ManuelRs1701/ROBOTICA/README.md

# ROBOTICA
Proyecto Final de Robotica
Robot antropomorfico de 4 grados de libertad
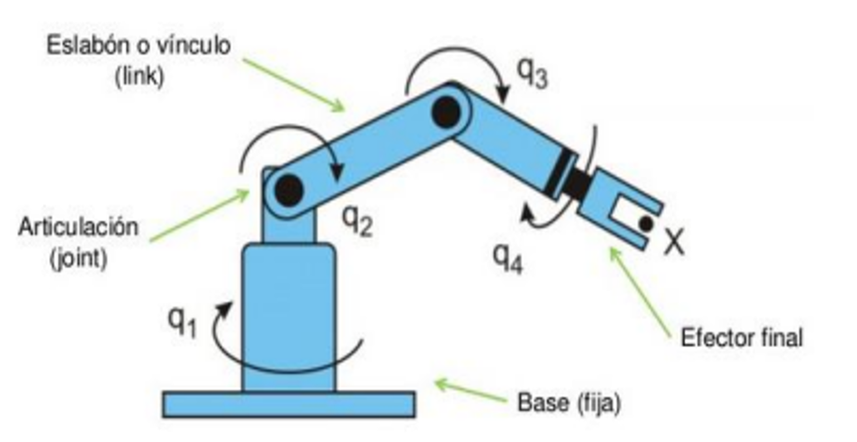
[picture p1: myt2022-040-fig1.png]
Mi imagen
