ManuelRs1701/ROBOTICA/PAPER FINAL ROBOT ANTROPOMORFICO.pdf

# Robot Antropomorfico de 4 Grados de Libertad

Emanuel Roman S ´ anchez ´
Universidad Catolica Boliviana ”San Pablo” ´ Estudiante - Ingeniería Mecatronica ´ emanuel.roman@ucb.edu.bo

Msc. Jose Jes ´ us Cabrera Pantoja ´
Universidad Catolica Boliviana ”San Pablo” ´ Docente - Ingeniería Mecatronica ´ jcabrera@ucb.edu.bo

Abstract—El presente documento detalla el desarrollo de un robot antropomorfico de cuatro grados de libertad, incluyendo ´
los calculos necesarios para su dise ´ | no, as ˜ | í como el analisis ´
de su cinematica directa e inversa. Adem ´ | as, se describen las ´
pruebas realizadas tanto en simulacion como en escenarios reales, ´ destacando los resultados obtenidos en cada etapa.
Index Terms—robot antropomorfico, grados de libertad, inge- ´
niería mecatronica, dise ´ | no, control ˜
I. INTRODUCCION´
La robotica es una disciplina que integra diversas ´ | areas de la ´
ingeniería, la informatica y las ciencias aplicadas, enfoc ´ | andose ´
en el diseno, construcci ˜ | on y operaci ´ | on de robots para realizar ´
tareas específicas de manera autonoma o semiaut ´ | onoma [1]. ´
Su importancia en el mundo actual radica en su capacidad para automatizar procesos, mejorar la eficiencia y precision´ en diversas industrias, y ofrecer soluciones innovadoras a problemas complejos [2].
Dentro de la robotica, los robots antropom ´ | orficos, tambi ´ | en´
conocidos como robots humanoides, son aquellos que emulan la forma y, en cierta medida, el comportamiento humano. Estos robots estan dise ´ nados para interactuar en entornos concebidos ˜ para personas, facilitando tareas que requieren adaptabilidad
y versatilidad [3]. Ademas, su aplicaci ´ | on en campos como ´
la medicina, la educacion y el entretenimiento ha aumentado ´
significativamente en los ultimos a ´ | nos [8]. ˜
Un concepto fundamental en el diseno y an ˜ | alisis de robots es ´
el de los grados de libertad (GDL), que representan el numero ´ de movimientos independientes que un robot puede realizar. En el caso de los robots antropomorficos, generalmente poseen ´ entre cinco y seis grados de libertad, permitiendo una amplia gama de movimientos y una mayor flexibilidad para ejecutar tareas complejas [4]. Esto los hace ideales para aplicaciones que requieren interacciones precisas y detalladas [6].
La | relevancia | de | estudiar | y | desarrollar | robots
antropomorficos radica en su potencial para revolucionar ´
diversas areas de la sociedad. Por ejemplo, en el ´ | ambito ´
industrial, estos robots pueden automatizar procesos que anteriormente dependían de habilidades humanas, mejorando la productividad y reduciendo los costos [7]. En la medicina,
los robots antropomorficos est ´ | an siendo utilizados para ´
realizar cirugías complejas con una precision inigualable, ´ mejorando los resultados clínicos y minimizando los riesgos [8].
Ademas, los avances en la rob ´ | otica permiten desarrollar ´
modelos cada vez mas avanzados que incorporan sensores, ac- ´ tuadores y algoritmos de control mas eficientes. Estos avances ´ han impulsado el uso de robots antropomorficos no solo en ´ entornos laborales, sino tambien en el hogar, donde pueden ´ asistir en tareas domesticas o incluso en el cuidado de personas ´ [3]. Por lo tanto, el estudio de estos sistemas roboticos no solo ´
contribuye al progreso tecnologico, sino que tambi ´ | en tiene un ´
impacto directo en la calidad de vida de las personas.
El proposito de este proyecto es dise ´ | nar y construir un brazo ˜
robotico funcional con cuatro grados de libertad, integrando ´ los conocimientos adquiridos durante el curso. Utilizando Python, MATLAB y Arduino IDE, se implementa un sistema
que proporciona retroalimentacion precisa sobre la posici ´ | on´
del efector final, lo cual facilita el aprendizaje y la aplicacion´
practica de los conceptos de cinem ´ | atica directa e inversa. ´

II. FUNDAMENTO TEORICO ´

A. Definicion de Grados de Libertad ´

Los grados de libertad (GDL) son una medida fundamental
en la robotica que define el n ´ | umero de movimientos indepen- ´
dientes que un sistema puede realizar [9]. En el contexto de un robot de cuatro grados de libertad, estos representan las articulaciones o ejes sobre los cuales el robot puede girar o desplazarse. Comprender los GDL es esencial para el diseno y ˜ analisis de robots, ya que permite determinar las capacidades ´ del sistema y las limitaciones en sus movimientos.


Fig. 1. Diagrama conceptual de los grados de libertad en un brazo robotico. ´

Este diagrama conceptual ilustra los grados de libertad (GDL) en un brazo robotico t ´ ípico. En la figura se muestran las articulaciones (joints) y los eslabones o vínculos (links) que componen la estructura del robot, destacando como cada ´ articulacion permite un movimiento independiente. Los grados ´ de libertad estan representados por las variables q1, q2, q3, ´ q4, que corresponden a las rotaciones o desplazamientos que el robot puede realizar en sus diferentes ejes. Ademas, se ´ identifica el efector final, que es el punto en el extremo del brazo encargado de realizar tareas específicas, y la base fija, que proporciona estabilidad al sistema. Este esquema es esencial para comprender como los movimientos de cada ´ articulacion se combinan para posicionar el efector final en el ´ espacio tridimensional.

B. Cinematica Directa ´
La cinematica es una rama de la rob ´ | otica que estudia ´
el movimiento de los sistemas mecanicos sin considerar las ´ fuerzas que los generan [10]. La cinematica directa se centra ´
en calcular la posicion y orientaci ´ | on del efector final a partir de ´
los valores conocidos de las articulaciones. Estas tecnicas son ´ fundamentales para el control y programacion de robots, ya ´ que permiten planificar trayectorias y movimientos precisos.
El calculo de la cinem ´ | atica directa se lleva a cabo utilizando ´
matrices de transformacion homog ´ | enea, las cuales combinan ´
tanto las rotaciones como los desplazamientos generados por las articulaciones del robot. En general, la transformacion´
homogenea para una articulaci ´ | on´ q se representa mediante la
matriz T, que esta compuesta por una matriz de rotaci ´ | on´ C y
un vector de desplazamiento r:

T =

Ci | r
0 | 1
(1)

donde:
- T: Matriz de transformada homogenea. ´
- Ci
: Matriz de rotacion. ´
- r: Vector de desplazamiento.
Las rotaciones en el espacio tridimensional son un aspecto esencial en la cinematica directa, particularmente cuando el robot ´ opera en un entorno tridimensional. La matriz de rotacion´ C
define como cambia la orientaci ´ | on del efector final respecto ´
al sistema de coordenadas base. Las rotaciones en torno a los ejes x, y y z estan representadas por las siguientes matrices: ´

Cx =

1 | 0 | 0

0 cos(θ) − sin(θ)

0 sin(θ) cos(θ)

(2)

Cy =

cos(θ) | 0 sin(θ)
0 | 1 | 0

− sin(θ) 0 cos(θ)

(3)

Cz =

cos(θ) − sin(θ) 0

sin(θ) | cos(θ) | 0
0 | 0 | 1

(4)

donde:

- Ci
: Matriz de rotacion en torno a un eje espec ´ | ífico.
- θ: Angulo de rotaci ´ | on del motor, expresado en radianes. ´

El desplazamiento de coordenadas se refiere al cambio de origen entre dos sistemas de referencia, generalmente entre la base del robot y el efector final. Cuando se utiliza un sistema de coordenadas (x, y, z) en la base y otro (x

′

, y′

, z′
) en el
efector final, la relacion entre ambos puede representarse me- ´
diante una matriz de transformacion homog ´ | enea que combina ´
rotaciones y traslaciones. El vector de traslacion´ r esta dado ´ por:

r =

x

y

z

(5)

donde:
- r: Representa el vector de traslacion. ´
Para determinar la posicion y orientaci ´ | on del efector final ´
(E) respecto al sistema de referencia inicial (I), se utiliza una secuencia de transformaciones homogeneas. Cada matriz ´ Ti−1,i describe como se transforma el sistema de coordenadas ´
de una articulacion “ ´ | i − 1” al sistema de la articulacion “ ´ | i”,
incorporando tanto rotaciones como desplazamientos. Esto se expresa como:

TI,E = TI,0 ·

Yn

i=1

Ti−1,i · Tn,E | (6)

donde:
- TI,E: Matriz de transformacion del sistema base ( ´ | I) al
efector final (E).
- TI,0: Matriz de transformacion inicial. ´
- Ti−1,i: Matriz de transformacion homog ´ | enea entre las ´
articulaciones i − 1 e i.
- Tn,E: Matriz de transformacion homog ´ | enea desde la ´
ultima articulaci ´ | on hasta el efector final. ´
La ecuacion (6) representa la transformaci ´ | | on completa ´
desde la base del robot hasta el efector final, integrando las rotaciones y traslaciones de todas las articulaciones. Este conjunto de transformaciones permite calcular la posicion y ´
orientacion del efector final seg ´ | un la configuraci ´ | on espec ´ | ífica
de cada articulacion. Al multiplicar todas las matrices en se- ´ cuencia, se obtiene la transformacion acumulada que describe ´ como se posiciona el efector final en el espacio tridimensional. ´
C. Cinematica Inversa ´
La cinematica inversa es un proceso esencial en la rob ´ | | | otica ´
que se utiliza para determinar las configuraciones articulares necesarias para que el efector final alcance una posicion y ´ orientacion deseadas en el espacio [11]. A diferencia de la ´
cinematica directa, que calcula la posici ´ | on del efector final ´
a partir de los valores conocidos de las articulaciones, la cinematica inversa resuelve el problema inverso, lo cual la ´ hace mas compleja debido a la naturaleza no lineal de las ´ ecuaciones involucradas.

Existen varios metodos para resolver la cinem ´ | atica inversa, ´
los cuales incluyen:
- Solucion anal ´ | ítica: Este enfoque consiste en resolver
directamente las ecuaciones algebraicas derivadas de la
transformacion homog ´ | enea. Es ´ | util en robots con config- ´
uraciones simples y simetricas, ya que permite obtener ´ soluciones exactas cuando las ecuaciones son manejables.
- Metodo num ´ | erico ´ | : Se basa en algoritmos iterativos,
como el metodo de Newton-Raphson, para aproximar las ´ soluciones. Este enfoque es ideal para robots con config-
uraciones mas complejas donde las soluciones anal ´ | íticas
no son factibles.
- Optimizacion´ : Utiliza tecnicas de optimizaci ´ | on para min- ´
imizar una funcion de costo que mide la diferencia entre ´
la posicion y orientaci ´ | on deseadas y las alcanzadas por el ´
efector final. Este metodo es com ´ | un en sistemas redun- ´
dantes o cuando existen multiples soluciones posibles. ´
- Aprendizaje basado en datos: En aplicaciones avan-zadas, como la robotica adaptativa, se utilizan redes neu- ´ ronales y otros modelos de aprendizaje para aproximar la solucion a partir de datos previos, lo cual puede ser ´ efectivo en entornos dinamicos. ´
Estos metodos permiten resolver problemas de cinem ´ | atica ´
inversa en una amplia variedad de sistemas roboticos, depen- ´ diendo de la complejidad del robot y de los requisitos de la tarea específica.
D. Servomotores
Los servomotores son actuadores esenciales en robotica, ´
disenados para controlar la posici ˜ | on, velocidad y torque ´
de una manera precisa [12]. A diferencia de los motores convencionales, los servomotores incluyen un sistema de retroalimentacion que permite ajustar continuamente su fun- ´ cionamiento para alcanzar los valores deseados.
1) Funcionamiento de los Servomotores: Un servomotor típico consta de tres componentes principales:
- Motor de corriente continua (DC): Genera el movimiento rotacional.
- Sistema de control: Regula la posicion y velocidad del ´ motor mediante senales de entrada (normalmente PWM). ˜
- Sensor de posicion´ : Mide la posicion angular del eje y ´ proporciona retroalimentacion al sistema de control. ´
El sistema de control compara la senal de referencia ˜
(posicion deseada) con la posici ´ | on actual y ajusta el motor para ´
minimizar el error. Este ciclo de retroalimentacion asegura un ´ control preciso en tiempo real.
2) Aplicaciones en Robotica: ´ En robotica, los servomotores ´ se utilizan comunmente para: ´
- Controlar las articulaciones de brazos roboticos. ´
- Manejar pinzas y herramientas de precision. ´
- Ajustar camaras o sensores para seguimiento din ´ | amico. ´
La capacidad de controlar con precision el movimiento hace ´ que los servomotores sean ideales para tareas que requieren alta repetitividad y exactitud, como en robots industriales y medicos. ´
3) Tipos de Servomotores: Los servomotores se clasifican principalmente en:
- Servomotores de corriente continua (DC): Populares por su simplicidad y rapidez en respuesta.
- Servomotores de corriente alterna (AC): Mas robustos ´ y adecuados para aplicaciones industriales de alta potencia.
- Servomotores digitales: Utilizan microcontroladores para un control mas preciso y personalizable. ´
Cada tipo de servomotor tiene sus ventajas segun la apli- ´
cacion, el rango de potencia y los requisitos de precisi ´ | on. ´
4) Consideraciones de Diseno: ˜ | Al seleccionar servomo-
tores para un proyecto robotico, es fundamental considerar ´ parametros como: ´
- Torque maximo necesario para mover las articulaciones. ´
- Velocidad angular requerida segun la tarea. ´
- Voltaje de operacion y compatibilidad con el sistema. ´
- Rango de movimiento angular y precision. ´
Estos factores aseguran que el sistema robotico funcione de ´ manera eficiente y confiable.

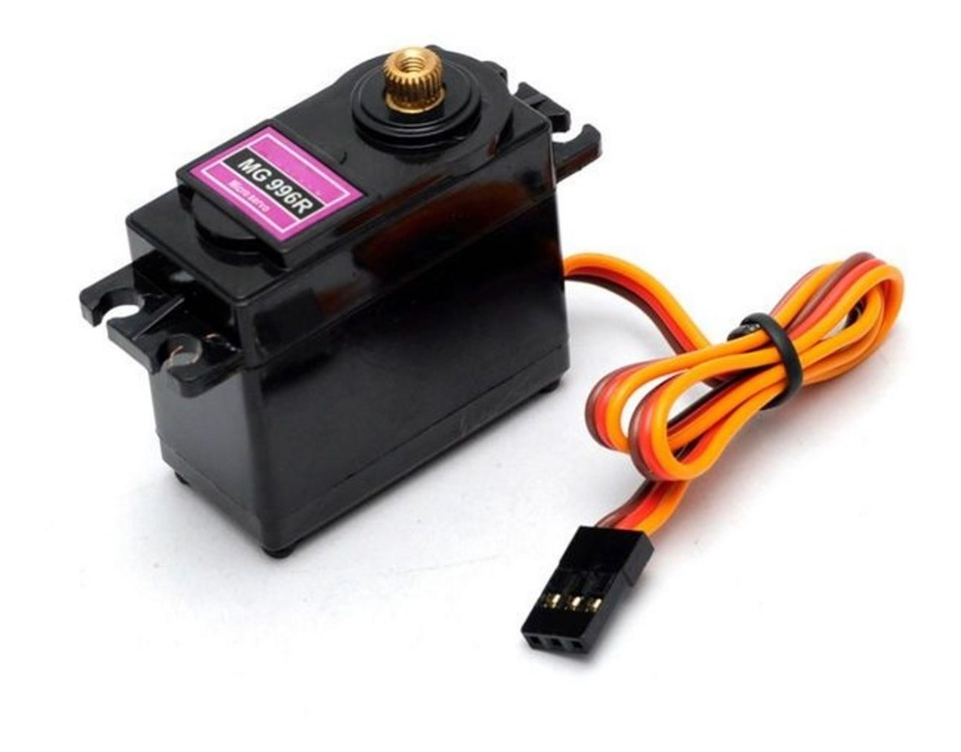
[picture p2: figure]

Fig. 2. Ejemplo de servomotor utilizado en aplicaciones roboticas. ´

E. Controlador PCA9685

El PCA9685 es un controlador de modulacion por ancho ´ de pulso (PWM) altamente eficiente y ampliamente utilizado
en proyectos de robotica y automatizaci ´ | on. Este dispositivo ´
permite controlar hasta 16 canales PWM de forma simultanea, ´ lo que lo hace ideal para manejar multiples servomotores en ´ un sistema robotico [ ´ ?].
1) Características Principales: El PCA9685 se destaca por las siguientes características:
- Control de 16 canales PWM independientes.
- Frecuencia ajustable de hasta 1.6 kHz.
- Comunicacion a trav ´ | es del protocolo I2C. ´
- Alimentacion flexible: puede operar con tensiones de ´ 3.3V o 5V.
- Capacidad para apilar multiples controladores mediante ´ la configuracion de direcciones I2C. ´

2) Funcionamiento: El PCA9685 genera senales PWM ˜ precisas para controlar dispositivos como servomotores y LEDs. Utiliza una comunicacion I2C para recibir comandos ´ desde un microcontrolador (como Arduino o Raspberry Pi), lo que simplifica el cableado y permite una configuracion´
rapida. Los valores de PWM se ajustan a trav ´ | es de registros ´
internos, permitiendo modificar la posicion de servomotores o ´ la intensidad de LEDs.
3) Aplicaciones en Robotica: ´ En proyectos roboticos, el ´ PCA9685 es particularmente util para: ´
- Controlar brazos roboticos con m ´ | ultiples articulaciones. ´
- Coordinar el movimiento de servomotores en robots bípedos o humanoides.
- Regular la intensidad de luces en sistemas de senalizaci ˜ on. ´
Gracias a su capacidad para manejar multiples canales ´
con precision, el PCA9685 es una herramienta vers ´ | atil para ´
sistemas roboticos complejos. ´
4) Ventajas: El PCA9685 ofrece varias ventajas, incluyendo:
- Reduccion del uso de pines de microcontroladores gracias ´ al protocolo I2C.
- Control de multiples dispositivos con un solo m ´ | odulo. ´
- Configuracion sencilla y r ´ | apida para aplicaciones de ´
automatizacion. ´

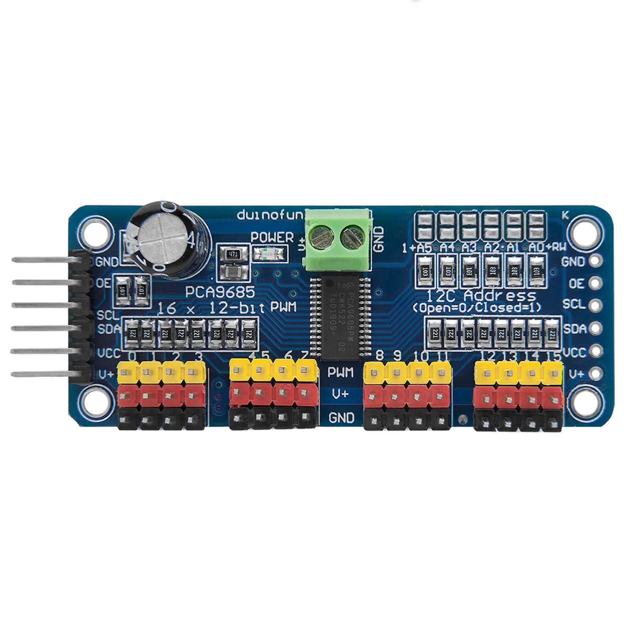
[picture p3: figure]

Fig. 3. Controlador PCA9685.

III. ESPECIFICACIONES DEL PROYECTO

A. Requerimientos
En el diseno de un brazo rob ˜ | otico de cuatro grados de lib- ´
ertad, es fundamental establecer parametros claros que gu ´ | íen
su desarrollo y aseguren el cumplimiento de los objetivos del proyecto. La tabla a continuacion detalla los requerim- ´
ientos de diseno, especificando los l ˜ | ímites y características
necesarias para garantizar el desempeno adecuado del sistema ˜
en terminos de peso, alcance, velocidad, torque, precisi ´ | on y ´
condiciones operativas.

TABLE I
TABLA DE REQUERIMIENTOS
Parametro ´ | Requerimiento | Unidad
Peso total del brazo Carga maxima soportada ´ Alcance maximo ´ Velocidad lineal deseada en el extremo Velocidad angular deseada de la garra Torque mínimo requerido en los servos Precision angular ´ Voltaje de operacion´ Temperatura de operacion´ | ≤ 500 100 30 5 0.17 - 0.27 ≥ 1 ±10 5 - 7.2 0 - 50 | g g cm cm/s rad/s Nm grado V ◦C

La tabla de requerimientos define los parametros que el ´ brazo robotico debe cumplir para operar de acuerdo con las ´ necesidades del proyecto. Estos requisitos incluyen el peso maximo permitido del brazo, que debe ser inferior a 500 ´ gramos, y la carga maxima soportada de 100 gramos, especi- ´ ficada para asegurar que el brazo manipule objetos ligeros sin sobrecargar los servos. El alcance maximo de 30 cm determina ´ la extension total desde la base hasta la punta de la garra. ´ Las velocidades de operacion se establecen con una ve- ´ locidad lineal en el extremo de 5 cm/s y una velocidad angular entre 0.17 y 0.27 rad/s, lo cual permite movimientos controlados y estables. El torque mínimo requerido de 1 Nm en los servos asegura que puedan soportar la carga y mover los eslabones sin perder fuerza. Otros parametros, como la ´ precision angular y el rango de voltaje de 5 a 7.2 V, se toman ´ en cuenta considerando el rango de operacion´ optimo para los ´ servos.

TABLE II
TABLA DE PESOS
Componente | Peso (g)
Base Servo 1 Pieza unica ´ | 193.32 45 148.32
Garra Final Servo 4 Garra | 60 45 15
Eslabon de 10 cm ´ Servo 2 Union´ | 23.13 45 9.73
Eslabon de 13 cm ´ Servo 3 Union´ | 114.41 45 13.82
Eslabon de 7 cm ´ Pieza unica ´ | 15.38 15.38
Peso Total | 406.24

El analisis de pesos mostrado en la tabla fue realizado ´ utilizando el software SolidWorks. Cada componente del brazo
robotico fue modelado digitalmente y se determin ´ | o su peso ´
considerando el material y las dimensiones asignadas en el diseno. Estos datos son fundamentales para garantizar que ˜
el brazo robotico cumpla con los requisitos de dise ´ | no en ˜
terminos de peso total y distribuci ´ | on de masa, asegurando as ´ | í
un rendimiento optimo en sus movimientos y operaciones. ´

- Garra: Incluye el servo asignado para la garra (45 g) y la propia garra (15 g), sumando un total de 60 g.
- Eslabon de 10 cm ´ | : Compuesto por dos piezas de eslabon´
y una union, con un peso total de 23.13 g. ´
- Eslabon de 13 cm ´ | : Contiene dos servos (45 g cada uno),
dos piezas de eslabon y una uni ´ | on, totalizando 114.41 g. ´
- Eslabon de 7 cm ´ | : Una pieza unica de 15.38 g. ´
El peso total del brazo robotico es 406.24 g. ´
| IV. MARCO PRACTICO

El marco practico de este proyecto describe las actividades ´ realizadas, los recursos utilizados y las metodologías implementadas para llevar a cabo el desarrollo del brazo robotico. ´
Esta seccion detalla los pasos pr ´ | acticos desde el dise ´ | no inicial ˜
hasta la validacion del sistema, incluyendo la construcci ´ | on del ´
prototipo, las pruebas funcionales y los ajustes necesarios para
garantizar un desempenõ optimo. Adem ´ | as, se reconocen los ´
aportes institucionales y tecnologicos que hicieron posible la ´ materializacion de este trabajo. ´
V. MARCO PRACTICO ´

El marco practico de este proyecto describe las actividades ´ realizadas, los recursos utilizados y las metodologías implementadas para llevar a cabo el desarrollo del brazo robotico. ´
Esta seccion detalla los pasos pr ´ | acticos desde el dise ´ | no inicial ˜
hasta la validacion del sistema, incluyendo la construcci ´ | on del ´
prototipo, las pruebas funcionales y los ajustes necesarios para
garantizar un desempenõ optimo. Adem ´ | as, se reconocen los ´
aportes institucionales y tecnologicos que hicieron posible la ´ materializacion de este trabajo. ´

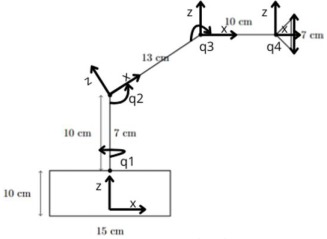
[picture p4: figure]

Fig. 4. Diagrama del robot utilizado en el desarrollo del proyecto.

El diagrama presentado ilustra la configuracion estructural ´
del brazo robotico de 4 grados de libertad. Cada articulaci ´ | on´
esta representada con su respectivo eje de rotaci ´ | on y coor- ´
denadas, marcadas como q1, q2, q3 y q4, que corresponden a los movimientos independientes del sistema. La base del robot, de dimensiones 15 cm x 10 cm, proporciona una estructura solida para soportar el resto del mecanismo. Los ´ enlaces, que miden 7 cm, 13 cm y 10 cm respectivamente, conectan las articulaciones y permiten que el brazo alcance diferentes posiciones en el espacio tridimensional. Este disenõ es esencial para cumplir con los requisitos de movilidad y precision establecidos en el proyecto, destacando la capacidad ´ del robot para operar dentro de su espacio de trabajo definido.
A. Calculos de Cinem ´ | atica Directa ´
La transformada homogenea es una herramienta funda- ´ mental en la cinematica directa, ya que permite describir ´ el movimiento y la posicion de los eslabones de un brazo ´ robotico en un sistema de coordenadas tridimensional. Esta ´
transformacion combina rotaciones y traslaciones en una ´ | unica ´
matriz, lo que facilita el calculo de la posici ´ | on y orientaci ´ | on´
del efector final en relacion con la base del robot. ´
Matematicamente, una matriz de transformaci ´ | on homog ´ | enea ´
esta compuesta por una matriz de rotaci ´ | on ( ´ | C) y un vector de
traslacion ( ´ | r), organizados de la siguiente manera:

T =

C r

0 1

A continuacion, se muestran las transformaciones ho- ´
mogeneas para los diferentes eslabones del brazo rob ´ | otico: ´

T01 =

C01

0
r01

0 1

- =

cos θz | − sin θz | 0 | 0
sin θz | cos θz | 0 | 0
0 | 0 | 1 l1
0 | 0 | 0 | 1

(1)

T12 =

C12

1
r12

0 1

- =

cos θy | 0 sin θy | l2
0 | 1 | 0 | 0
− sin θy | 0 cos θy | 0
0 | 0 | 0 | 1

(2)

T23 =

C23

2
r2F

0 1

- =

cos ϕy | 0 sin ϕy | l3
0 | 1 | 0 | 0
− sin ϕy | 0 cos ϕy | 0
0 | 0 | 0 | 1

(3)

T3F =

C3F

3
r3F

0 1

- =

1 | 0 | 0 | 0
0 cos θx | − sin θx | 0
0 sin θx | cos θx | 0
0 | 0 | 0 | 1

(4)

Estas matrices describen las relaciones entre los diferentes
eslabones y permiten calcular la posicion y orientaci ´ | on del ´

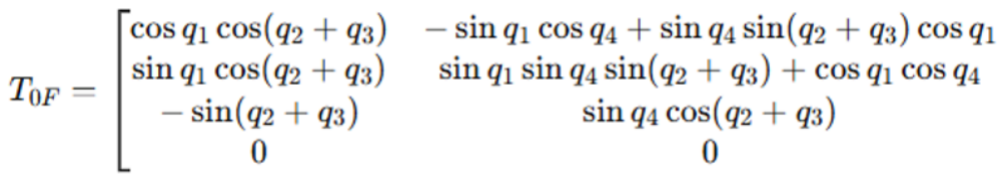
[picture p5: figure]
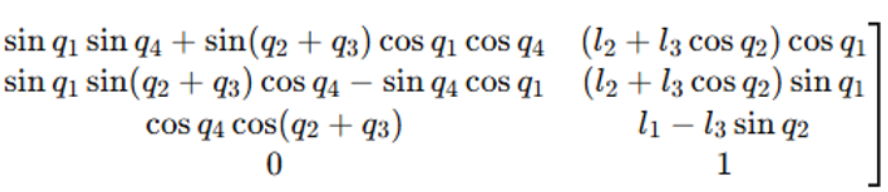
[picture p6: figure]

Fig. 5. Matriz de transformacion homog ´ | enea ´ | T0F .

efector final acumulando las transformaciones sucesivas desde la base hasta el extremo del brazo robotico. ´
La matriz de transformacion homog ´ | enea ´ | T0F describe la
posicion y orientaci ´ | on del efector final del brazo rob ´ | otico en ´
relacion con la base. En esta matriz: ´
- Las primeras tres columnas representan la rotacion del ´ sistema de referencia del efector final con respecto al sistema base.
- La ultima columna indica la traslaci ´ | on del efector final, ´
considerando las longitudes de los eslabones l1, l2, y l3,
así como los angulos articulares ´ | q1, q2, q3 y q4.
- La ultima fila, ´ | [0 0 0 1], se utiliza para mantener la
consistencia de las transformaciones homogeneas. ´

Esta matriz permite calcular de manera precisa tanto la
orientacion como la posici ´ | on del efector final, lo que es ´
crucial para tareas como la planificacion de trayectorias y la ´ programacion del robot. ´
La transformada homogenea tambi ´ | en se utiliza como base ´
para calcular la matriz Jacobiana. Para ello, se toman los primeros tres valores de la ultima columna de la matriz ´ de transformacion, los cuales representan las posiciones del ´ efector final en el espacio tridimensional.
A partir de estos valores, se obtienen las derivadas par-ciales correspondientes, asignando cada columna de la matriz Jacobiana al motor asociado. Este proceso permite relacionar
los movimientos articulares con la posicion y orientaci ´ | on del ´
efector final.

JT =

−(l2 + l3 cos q2) sin q1 | −l3 sin q2 cos q1 | 0 0
(l2 + l3 cos q2) cos q1 | −l3 sin q1 sin q2 | 0 0
0 | −l3 cos q2 | 0 0
B. Cinematica Inversa ´
La cinematica inversa es una t ´ | ecnica fundamental que ´
permite calcular los angulos articulares necesarios para que ´
el efector final alcance una posicion y orientaci ´ | on deseadas ´
en el espacio. Este procedimiento se utiliza para resolver el movimiento de los robots manipuladores desde el espacio cartesiano hasta el espacio articular. La cinematica inversa es ´ esencial para tareas como la planificacion de trayectorias y la ´ interaccion con el entorno, garantizando que el manipulador ´ pueda operar de manera precisa y eficiente.
1) Formula para el ´ | angulo ´ | q1: La formula para ´ | q1 se
obtiene al analizar el movimiento en el plano horizontal (XY).
Este angulo se calcula utilizando la funci ´ | | on arco tangente para ´
determinar la relacion entre las coordenadas ´ | | | px y py:

q1 = arctan
| | py
| | px

**Explicacion**: El ´ | angulo ´ | q1 alinea el manipulador en el
plano horizontal para alcanzar las coordenadas (px, py).
**Justificacion**: Esta relaci ´ | | on se basa en principios de ´
trigonometría en un triangulo proyectado en el plano XY, ´ donde px y py representan las componentes de la posicion´ deseada.
2) Formula para el ´ | angulo ´ | q2: El calculo de ´ | q2 considera el
plano vertical (XZ) e incluye la contribucion del tercer enlace ´
(l3). La formula completa se divide en dos t ´ | erminos: ´

q2 = arctan

q

pz − l1

p

2
x + p

2
y
- − arctan
l3 sin(q3)
l2 + l3 cos(q3)

Primera parte:

arctan

q

pz − l1

p

2
x + p

2
y
Este termino calcula el ´ | angulo inicial necesario para alinear ´
el manipulador en el plano vertical, considerando la altura del
efector final y la contribucion del primer enlace ( ´ | l1).
Segunda parte:

arctan
l3 sin(q3)
l2 + l3 cos(q3)

Este termino ajusta ´ | q2 considerando la influencia del tercer
enlace (l3).
3) Formula para el ´ | angulo ´ | q3: El angulo ´ | q3 se determina
usando el Teorema del Coseno, que relaciona las longitudes de los enlaces y la distancia total entre el origen y la posicion´ final del efector. La formula inicial es: ´

cos(q3) =

p

2
| x + p

2
| | y + (pz − l1)

2 − l

| | | 2 2 − l
| | | 2
| | | 3
| | 2 · l2 · l3
Para obtener q3, se utiliza la relacion entre seno y coseno: ´
| q3 = arctan | p 1 − cos²(q3)
| | cos(q3)

!

El termino ´ | cos(q3) se deriva del Teorema del Coseno:
| c 2 = a 2 + b 2 − 2 · a · b · cos(θ)

donde c es la distancia entre el origen y el efector final, y a y b son las longitudes de los enlaces.
Una vez calculado cos(q3), se utiliza la relacion´
trigonometrica para obtener ´ | q3 en radianes.
Las formulas de cinem ´ | atica inversa permiten transformar ´
las coordenadas del espacio cartesiano a angulos articulares, ´

basandose en principios de trigonometr ´ | ía y geometría. Estas
herramientas garantizan que el manipulador pueda alcanzar cualquier posicion deseada dentro de su espacio de trabajo de ´ manera precisa.

q1 = arctan
py
px
| (1)

q2 = arctan

q

pz − l1

p

2
x + p

2
y
- − arctan
l3 sin(q3)
l2 + l3 cos(q3)
(2)

q3 = arctan p
1 − cos²(q3)
cos(q3)

!
(3)
C. Espacio de Trabajo
El espacio de trabajo de un manipulador robotico se define ´ como la region del espacio tridimensional en la que el efector ´ final puede operar, alcanzando posiciones y orientaciones determinadas. Este espacio esta influenciado por factores como ´
la longitud de los eslabones, los angulos de articulaci ´ | on y las ´
restricciones mecanicas del sistema. Comprender el espacio de ´ trabajo es crucial para garantizar que el manipulador pueda realizar las tareas requeridas dentro de su entorno operativo.

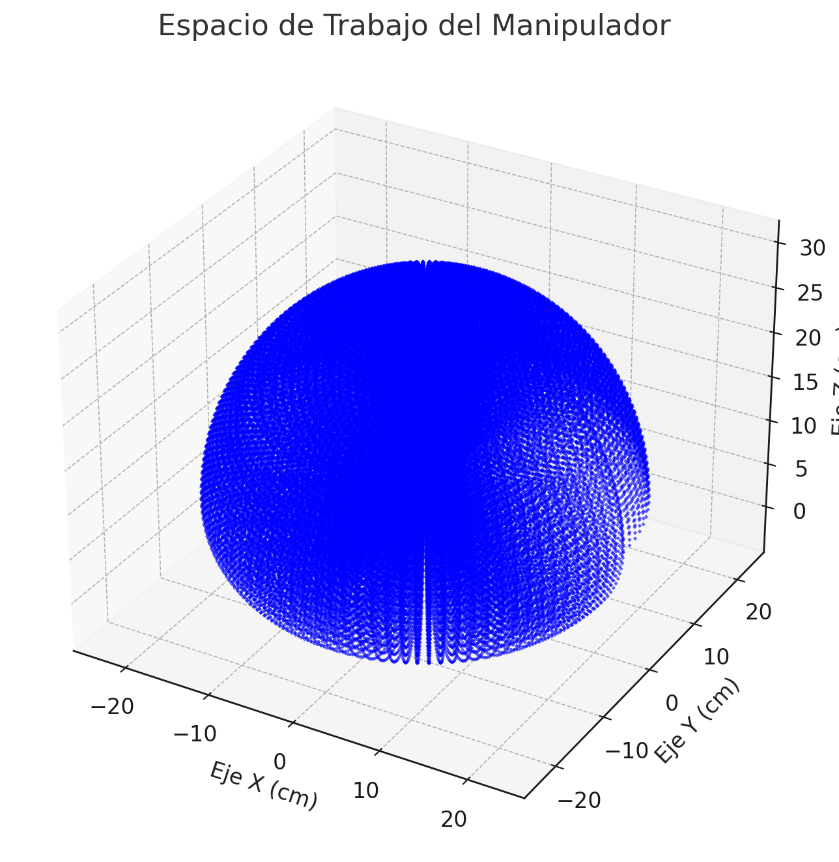
[picture p7: figure]

Fig. 6. Representacion gr ´ | afica del espacio de trabajo del brazo rob ´ | otico. ´

La imagen representa el espacio de trabajo tridimensional
del manipulador robotico, el cual se define como la regi ´ | on´
alcanzable por el efector final en terminos de posici ´ | on. Este ´
espacio esta determinado por las longitudes de los eslabones, ´
los angulos de las articulaciones y las limitaciones mec ´ | | anicas ´
del sistema. En este caso, el espacio de trabajo tiene una forma hemisferica, lo que refleja la capacidad del manipulador para ´ realizar movimientos en un rango amplio en los ejes X, Y y Z. Este analisis es crucial para validar que el manipulador puede ´ cubrir el area necesaria para las tareas asignadas, asegurando ´ su eficacia en aplicaciones específicas.
D. Componentes
El diseno del manipulador rob ˜ | otico incluye una variedad ´
de componentes que trabajan en conjunto para garantizar su funcionalidad. La siguiente tabla resume los elementos principales utilizados en este proyecto, junto con sus respectivas cantidades:

TABLE III
LISTA DE COMPONENTES UTILIZADOS
Componente | Cantidad
Plancha de MDF | 1
Servo motor MG996 | 4
Cables Dupont | 30
ESP32 | 1
PCA9685 | 1
Fuente de PC | 1

VI. RESULTADOS

Los resultados obtenidos fueron validados a traves de una ´ simulacion llevada a cabo en MATLAB utilizando la bib- ´ lioteca Robotics Toolbox. Esta herramienta permite realizar modelados y simulaciones precisas de sistemas roboticos, ´ proporcionando un entorno robusto y flexible para analizar
el desempeno del manipulador. Mediante esta simulaci ˜ | on, se ´
verificaron las soluciones de la cinematica inversa y se evalu ´ | ó
la capacidad del robot para alcanzar posiciones específicas dentro de su espacio de trabajo.

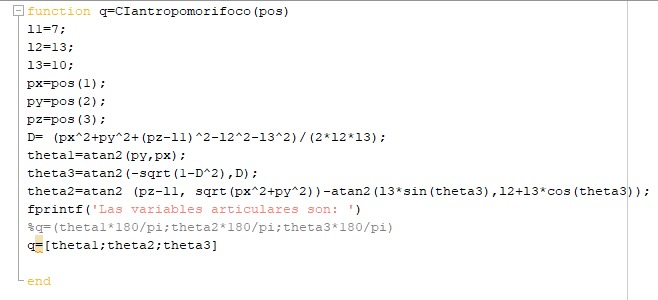
[picture p8: figure]

Fig. 7. Simulacion de la cinem ´ | atica inversa en MATLAB utilizando la funci ´ | on´
personalizada.

La Figura muestra los resultados obtenidos al ejecutar la
funcion de cinem ´ | atica inversa implementada en MATLAB. ´
Esta funcion calcula los ´ | angulos articulares ´ | θ1, θ2 y θ3 para
alcanzar una posicion espec ´ | | ífica definida por las coordenadas
px, py y pz. La simulacion permite verificar la exactitud de ´ los calculos realizados y confirmar que el manipulador puede ´ posicionarse correctamente dentro de su espacio de trabajo. Este procedimiento es esencial para validar las capacidades del robot en aplicaciones practicas. ´

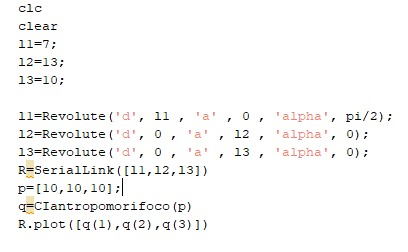
[picture p9: figure]

Fig. 8. | Grafica de la posici ´ | on del manipulador utilizando MATLAB y ´
Robotics Toolbox.

La imagen muestra el codigo utilizado para graficar la ´
posicion del manipulador rob ´ | otico en el espacio tridimen- ´
sional. Este script utiliza la biblioteca Robotics Toolbox en MATLAB, definiendo los parametros de cada enlace mediante ´ objetos ‘Revolute‘ y uniendo los enlaces con ‘SerialLink‘. Los valores de l1, l2 y l3 representan las longitudes de los eslabones del manipulador.
En este caso, se define un punto objetivo [px, py, pz] = [10, 10, 10], que se convierte en los angulos articulares ´
(q1, q2, q3) mediante la funcion de cinem ´ | atica inversa previa- ´
mente implementada. Finalmente, el comando ‘R.plot‘ genera
una representacion gr ´ | afica de la posici ´ | on del manipulador, ´
permitiendo visualizar y validar el movimiento en el espacio de trabajo.

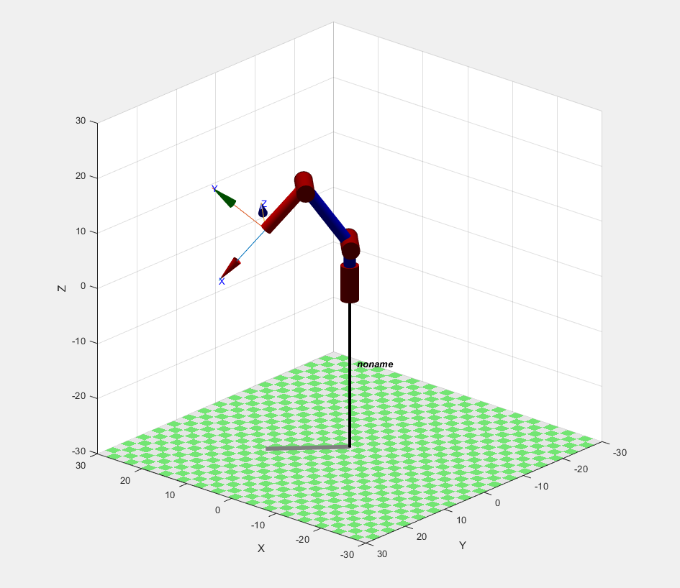
[picture p10: figure]

Fig. 9. Visualizacion de la posici ´ | on alcanzada por el manipulador en el punto ´
objetivo.

La imagen muestra la simulacion gr ´ afica del manipulador ´ robotico alcanzando el punto objetivo especificado en las ´ coordenadas [px, py, pz] = [10, 10, 10]. Como se observa, el efector final del manipulador logra posicionarse correctamente dentro del espacio de trabajo, validando el calculo realizado ´ mediante la cinematica inversa. Este resultado confirma que ´ las formulas implementadas son precisas y que el manipu- ´ lador puede cumplir con las especificaciones del diseno para ˜ alcanzar cualquier posicion dentro de su rango operativo. ´

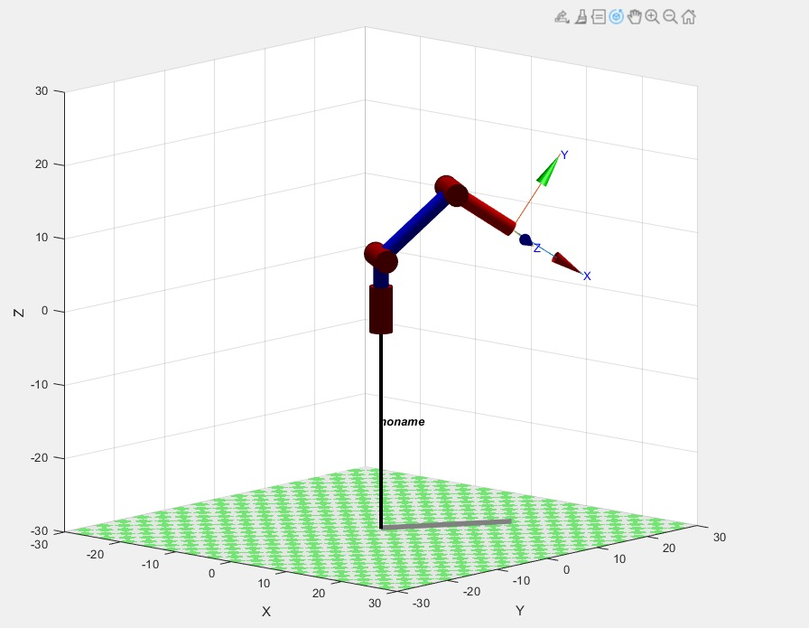
[picture p11: figure]

Fig. 10. Simulacion del manipulador alcanzando m ´ | ultiples puntos en el ´
espacio de trabajo.
La imagen muestra la simulacion del manipulador rob ´ | otico ´
alcanzando multiples puntos distribuidos en su espacio de ´ trabajo. Esto demuestra la capacidad del sistema para operar en diferentes posiciones específicas, verificando la precision´
de los calculos de cinem ´ | atica inversa en distintos escenarios. ´

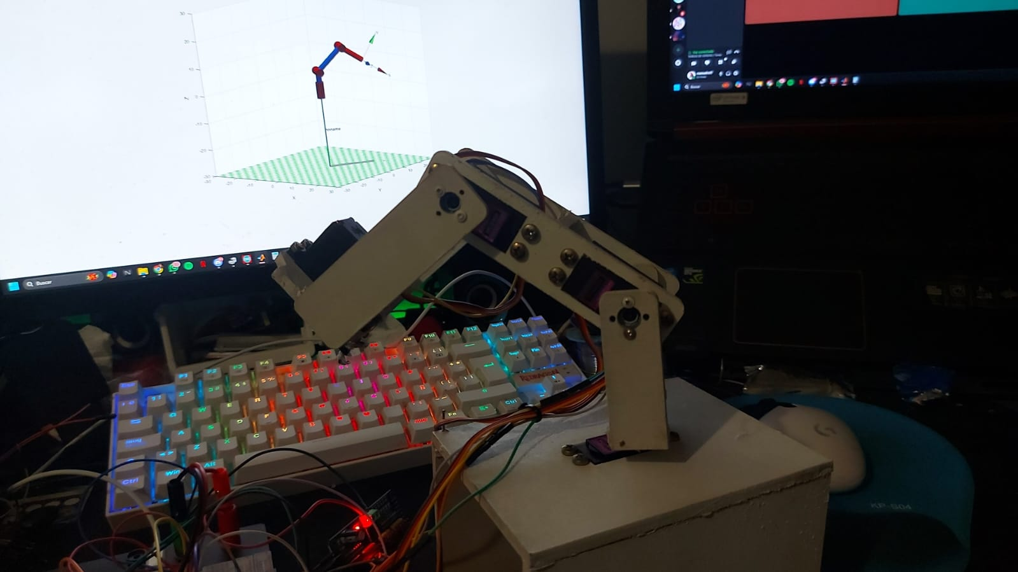
[picture p12: figure]

Fig. 11. | Comparacion entre la simulaci ´ | on y el funcionamiento real del ´
manipulador.

En esta imagen se compara la simulacion del manipulador ´ con su implementacion en la vida real. Los resultados mues- ´ tran que el comportamiento del robot en la simulacion es ´
consistente con su desempeno en el entorno f ˜ | ísico, validando
así la precision de los modelos matem ´ | aticos y la programaci ´ | on´
utilizada.
A. Comparacion de ´ | Angulos para la Posici ´ | on [10,10,10] ´

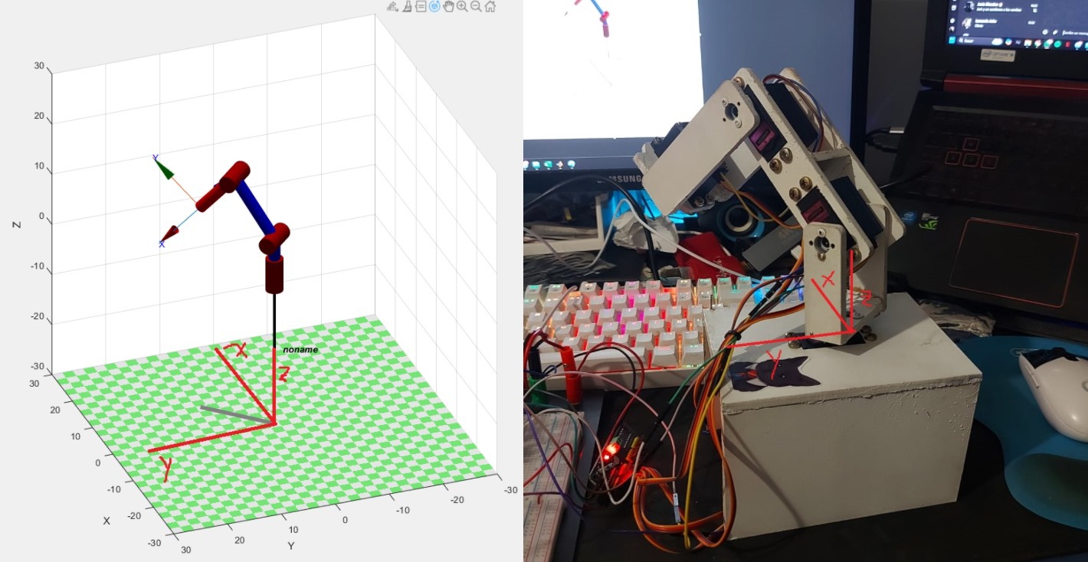
[picture p13: figure]

Fig. 12. Comparacion entre el modelo simulado y el modelo real del brazo ´
robotico en la posici ´ | on (10,10,10). ´

El diagrama de la Figura 12 presenta una comparacion´ visual entre el modelo simulado y el modelo real del brazo
robotico al alcanzar la posici ´ | on (10,10,10). En la simulaci ´ | on, ´
los ejes se alinean perfectamente en el espacio tridimensional,
mostrando la orientacion del manipulador en relaci ´ | on a la ´
base y la configuracion angular calculada. En el modelo f ´ | | ísico,
aunque se evidencia una ligera desviacion, se puede observar ´ que el manipulador es capaz de acercarse a la posicion´ objetivo, validando el funcionamiento del sistema de control y la precision en los servomotores utilizados. ´

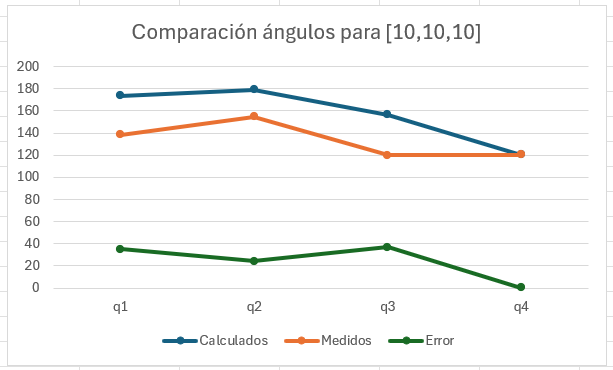
[picture p14: figure]

Fig. 13. Comparacion de ´ | angulos calculados, medidos y error para la posici ´ | on´
(10,10,10).

La grafica de la Figura 13 muestra los valores de los ´
angulos articulados calculados te ´ | oricamente y los medidos ´
experimentalmente al posicionar el brazo en las coordenadas (10,10,10). A continuacion, se presenta la tabla de valores ´ correspondientes:

TABLE IV
TABLA DE COMPARACION DE ´ | ANGULOS PARA LA POSICI ´ | ON´ (10,10,10).
Motor | Calculados (◦) | Medidos (◦) | Error (◦)
q1 | 173.52 | 138.52 | 35.00
q2 | 178.86 | 154.58 | 24.28
q3 | 156.48 | 119.82 | 36.66
q4 | 120.53 | 120.41 | 0.12

Como se puede observar en la tabla, el error mas signi- ´
ficativo se presenta en el angulo ´ | q3 con un valor de 36.66◦
,
lo cual indica una desviacion considerable en la alineaci ´ | on´
del enlace correspondiente. El angulo ´ | q1 tambien presenta un ´
error notable de 35◦
, mientras que q2 y q4 muestran valores
mas ajustados, con errores de 24.28 ´ | ◦ y 0.12◦ , respectivamente.
La desviacion promedio de los ´ | angulos para esta prueba ´
es aproximadamente del 24.51%, lo cual se debe en parte
a las tolerancias mecanicas y la precisi ´ | on limitada de los ´
servomotores. A pesar de estas diferencias, el sistema logra posicionarse con exito dentro de un margen aceptable en el ´ espacio objetivo.
B. Comparacion de ´ | Angulos para la Posici ´ | on [15,10,15] ´

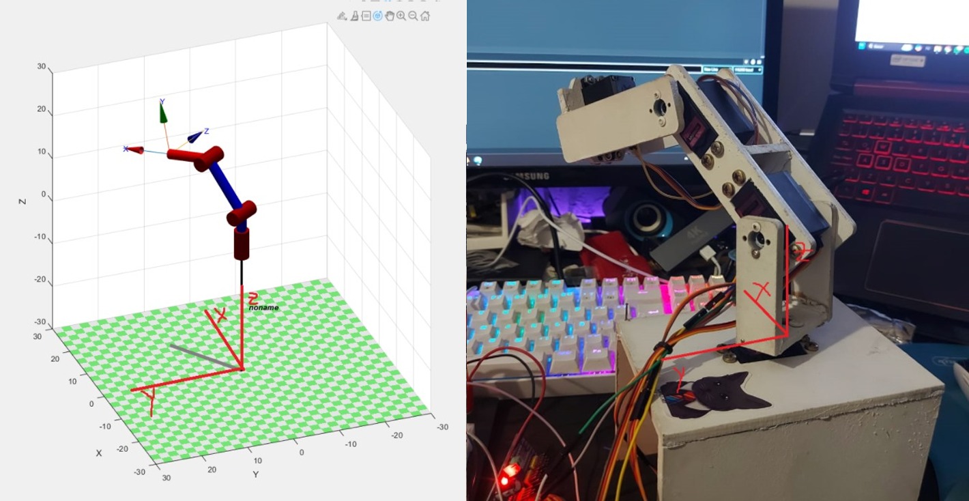
[picture p15: figure]

Fig. 14. Comparacion entre el modelo simulado y el robot real para la posici ´ | on´
(15,10,15).

En la Figura 14, se muestra la comparacion entre el modelo ´ simulado y el brazo robotico real al posicionarse en las coor- ´ denadas (15,10,15). Visualmente, se observa que la simulacion´ realizada en MATLAB presenta una correspondencia ade-cuada con el comportamiento del robot físico, aunque existen
pequenas discrepancias debido a las tolerancias mec ˜ | anicas y ´
a la precision de los servomotores. ´

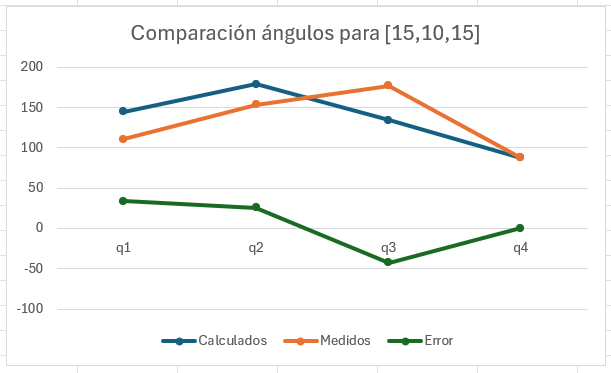
[picture p16: figure]

Fig. 15. Grafica de comparaci ´ | on de ´ | angulos calculados y medidos para la ´
posicion (15,10,15). ´

En la Figura 15, se presenta la grafica comparativa de los ´
angulos te ´ | oricos ( ´ | calculados) y los angulos experimentales ´
(medidos) correspondientes a la posicion (15,10,15). A con- ´ tinuacion, se detalla la tabla con los valores obtenidos: ´

TABLE V
COMPARACION DE ´ | ANGULOS CALCULADOS ´ | , MEDIDOS Y ERROR PARA LA
POSICION´ (15,10,15).
Motor | Calculados (°) | Medidos (°) | Error (°)
q1 | 144,63 | 110,94 | 33,69
q2 | 178,93 | 153,27 | 25,66
q3 | 134,55 | 177,06 | -42,51
q4 | 87,8 | 87,75 | 0,05
La comparacion muestra que los ´ | angulos ´ | q1 y q2 tienen
errores moderados, con desviaciones de 33.69◦ y 25.66◦ respectivamente, lo que se atribuye a las tolerancias mecanicas ´ del sistema y al funcionamiento de los servomotores. En

cambio, el angulo ´ | q3 presenta una discrepancia negativa sig-
nificativa de −42.51◦
, indicando un fallo en la precision del ´
tercer eslabon durante la alineaci ´ | on vertical. Por ´ | ultimo, el ´
angulo ´ | q4 exhibe un error practicamente nulo, lo que sugiere ´
un ajuste correcto en esa articulacion. ´
El error global promedio para esta posicion fue del ´ | 23.6%,
lo cual refleja un comportamiento ligeramente mas desfavor- ´ able en comparacion con otras posiciones evaluadas. Estos re- ´ sultados reafirman la importancia de calibrar los servomotores
y optimizar las tolerancias mecanicas para mejorar la precisi ´ | on´
del robot.
C. Comparacion de ´ | Angulos para la Posici ´ | on [7,14,7] ´

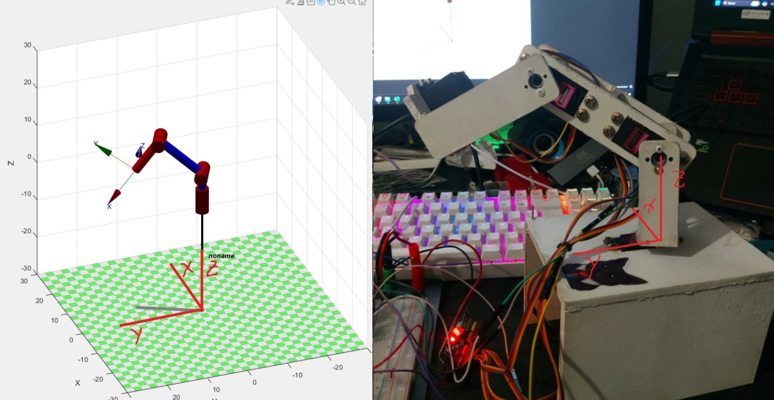
[picture p17: figure]

Fig. 16. | Comparacion visual entre la simulaci ´ | on del manipulador y su ´
implementacion f ´ | ísica para la posicion (7,14,7). ´

En la Figura 16 se observa la comparacion entre la sim- ´ ulacion en MATLAB y el comportamiento real del brazo ´
robotico al posicionarlo en las coordenadas ´ | | | (7, 14, 7). La
imagen de la izquierda representa la simulacion del modelo ´
matematico, mostrando la orientaci ´ | on y los ´ | angulos te ´ | oricos ´
alcanzados por el manipulador. En contraste, la imagen de la derecha presenta el robot físico, el cual replico la misma con- ´
figuracion con peque ´ | nas diferencias causadas por la precisi ˜ | on´
de los servomotores y las tolerancias mecanicas del sistema. ´ La consistencia entre ambas imagenes valida la efectividad del ´ modelo de simulacion desarrollado. ´

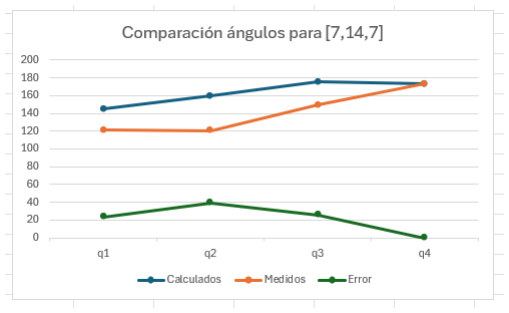
[picture p18: figure]

Fig. 17. Comparacion de ´ | angulos calculados y medidos para la posici ´ | on´
(7,14,7).

En la Figura 17, se presenta la comparacion entre los ´
angulos calculados te ´ | oricamente y los medidos experimen- ´
talmente para la posicion´ (7, 14, 7). La tabla correspondiente
muestra los valores de los angulos ´ | q1, q2, q3 y q4, así como
el error resultante entre los valores calculados y medidos.

TABLE VI
COMPARACION DE ´ | ANGULOS CALCULADOS Y MEDIDOS PARA LA ´
POSICION´ (7,14,7).
Angulo ´ | Calculados (°) | Medidos (°) | Error (°)
q1 | 145.1 | 121.67 | 23.43
q2 | 159.59 | 120.08 | 39.51
q3 | 175.37 | 149.67 | 25.7
q4 | 172.99 | 172.91 | 0.08

Se observa que el error en q2 presenta el valor mas significa- ´ tivo, alcanzando aproximadamente 39.51◦
, lo que sugiere una
mayor desviacion en el ´ | angulo inclinado vertical. Esto podr ´ | ía
deberse a las limitaciones mecanicas del robot y la precisi ´ | on de ´
los servomotores. En contraste, el angulo ´ | q4 presenta un error
insignificante de 0.08◦
, indicando que la articulacion final del ´
manipulador tuvo una alta precision en su orientaci ´ | on. ´
El error global promedio para esta posicion es del 25.2%, ´
reflejando una desviacion moderada en comparaci ´ | on con las ´
posiciones anteriores. La capacidad del modelo de simulacion´ para predecir los angulos correctos es notable, aunque factores ´ como la carga adicional y las tolerancias mecanicas del robot ´ físico continuan influyendo en los resultados experimentales. ´

VII. CONCLUSION´

En el desarrollo del proyecto, se construyo un brazo rob ´ | otico ´
de 4 grados de libertad capaz de posicionarse en coordenadas
específicas utilizando calculos de cinem ´ | atica directa e inversa. ´
Durante la validacion experimental, se observaron discrepan- ´
cias entre los angulos calculados te ´ | oricamente y los medidos ´
físicamente en las posiciones de prueba.
Para la posicion´ (10, 10, 10), los errores maximos se regis- ´
traron en el angulo ´ | q3 con un valor de 36.66◦
, mientras que
el error global promedio fue del **24.4%**. En la posicion´
(15, 10, 15), se encontro una mayor desviaci ´ | on en el ´ | angulo ´ | q3
con un error negativo de −42.51◦
, y un error global promedio
de **25.2%**. Finalmente, para la posicion´ | (7, 14, 7), el
angulo ´ | q2 presento el error m ´ | as significativo de ´ | 39.51◦
, con
un error global promedio calculado en **22.5%**.
El peso total del brazo robotico construido alcanz ´ | o los ´
**532 gramos**, mientras que su capacidad de carga efectiva fue de **453 gramos** antes de alcanzar el límite estructural. Esta capacidad supera ampliamente el requerimiento inicial de
300 g, validando la resistencia del diseno mec ˜ | anico propuesto. ´
En terminos de precisi ´ | on, las simulaciones lograron replicar ´
con exito el movimiento del manipulador en un entorno virtual, ´ mientras que las pruebas físicas evidenciaron las limitaciones mecanicas y la influencia de las tolerancias en los servomo- ´ tores. La diferencia promedio entre los angulos calculados y ´ medidos se encuentra dentro de un margen aceptable para aplicaciones de baja carga, lo cual demuestra la viabilidad del modelo implementado. Sin embargo, se recomienda la incorporacion de sensores adicionales para mejorar la retroal- ´
imentacion y la precisi ´ | on del sistema en futuras iteraciones. ´

REFERENCES

[1] Concepto.de, “Robotica – Concepto, historia, tipos, beneficios y carac- ´ terísticas,” [En línea]. Disponible en: https://concepto.de/robotica/.
[2] RoboticaiO.com, “La Importancia de la Robotica en el Mundo Actual,” ´ 24 de septiembre de 2024. [En línea]. Disponible en: https://robotica10.com/robotica/importancia-de-la-robotica/.
[3] Aleph.org.mx, “¿Cual es la importancia de la rob ´ | otica en la ´
actualidad?” | [En | línea]. | Disponible | en: | https://aleph.org.mx/
cual-es-la-importancia-de-la-robotica-en-la-actualidad/.
[4] Arhataraht.files.wordpress.com, “ROBOTS ANTROPOMORFICOS,” [En línea]. Disponible en: https://arhataraht.files.wordpress.com/2014/07/robots antropomorficos.pdf.
[5] Dialnet.unirioja.es, “La importancia de la Robotica como eje en el ´ desarrollo de la sociedad,” [En línea]. Disponible en: https://dialnet.unirioja.es/descarga/articulo/7554370.pdf.
[6] Tecnical.biz, | “Introduccion | a | los | robots | Antropomorfos,” ´
[En | línea]. | Disponible | en: | https://tecnical.cat/actualidad/
introduccion-a-los-robots-antropomorfos/.
[7] UNIR, “¿Que es la rob ´ | otica industrial? Concepto, usos y fu- ´
turo,” [En línea]. Disponible en: https://www.unir.net/revista/ingenieria/robotica-industrial/.
[8] Todoingenierias.com, “Robots en la medicina: aplicaciones y usos en el
ambito m ´ | edico,” [En l ´ | ínea]. Disponible en: https://todoingenierias.com/
robots-en-la-medicina-aplicaciones-y-usos-en-el-ambito-medico/.
[9] J. J. Craig, “Introduction to Robotics: Mechanics and Control,” 4th ed., Pearson, 2016.
[10] J. Angeles, “Fundamentals of Robotic Mechanical Systems: Theory, Methods, and Algorithms,” 4th ed., Springer, 2014.
[11] Siciliano, B., Sciavicco, L., Villani, L., & Oriolo, G., “Robotics: Mod-elling, Planning and Control,” Springer, 2010.
[12] Adafruit, “PCA9685 16-Channel 12-bit PWM Servo Driver,” [En línea]. Disponible en: https://learn.adafruit.com/16-channel-pwm-servo-driver.

20

19

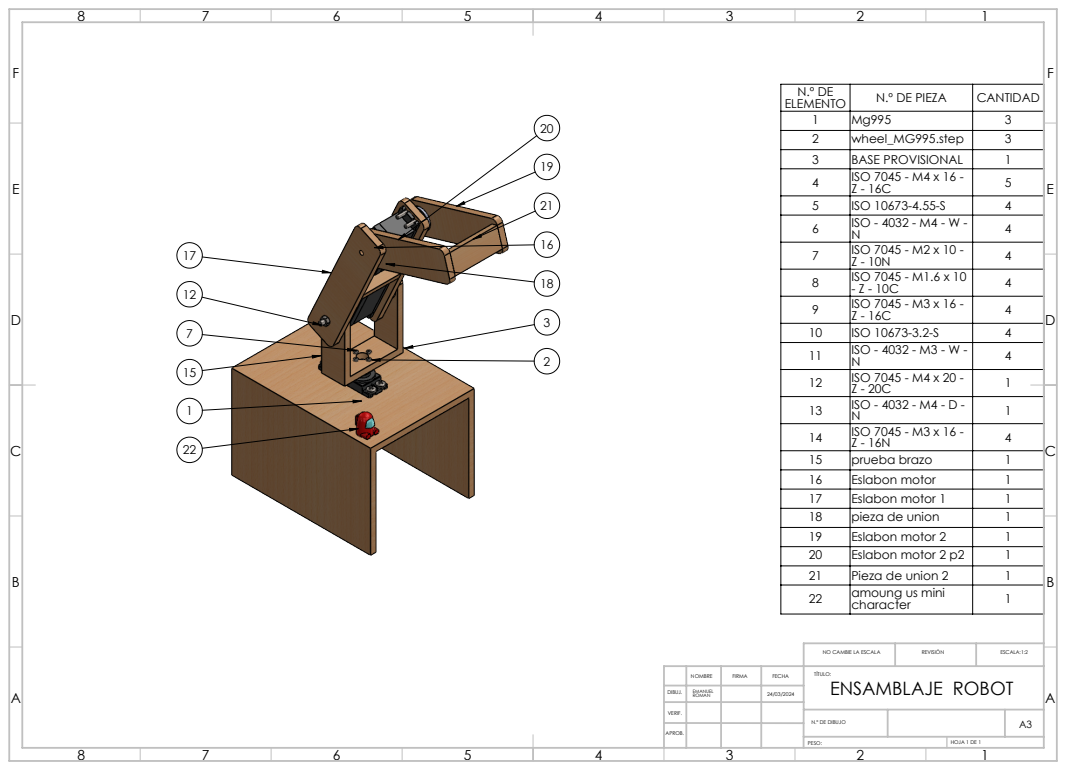
[picture p19: page 12]

N.º DE
ELEMENTO | wheel_MG995.step BASE PROVISIONAL ISO 7045 - M4 x 16 -Mg995 N.º DE PIEZA | CANTIDAD 1 3 2 3 3 1 4

Z - 16C | 5
5 | ISO 10673-4.55-S | 4
6 | ISO - 4032 - M4 - W - N | 4
7 | ISO 7045 - M2 x 10 -Z - 10N | 4
8 | ISO 7045 - M1.6 x 10 - Z - 10C | 4
9 | ISO 7045 - M3 x 16 -Z - 16C | 4
10 | ISO 10673-3.2-S | 4
11 | ISO - 4032 - M3 - W - N | 4
12 | ISO 7045 - M4 x 20 -Z - 20C | 1
13 | ISO - 4032 - M4 - D - N | 1
14 | ISO 7045 - M3 x 16 -Z - 16N | 4
15 | prueba brazo | 1
16 | Eslabon motor | 1
17 | Eslabon motor 1 | 1
18 | pieza de union | 1
19 | Eslabon motor 2 | 1
20 | Eslabon motor 2 p2 | 1
21 | Pieza de union 2 | 1
22 | amoung us mini character | 1

NO CAMBIE LA ESCALA | REVISIÓN | ESCALA:1:2

NOMBRE EMANUEL | FIRMA | FECHA 24/03/2024 | TÍTULO: ENSAMBLAJE ROBOT ROMAN

DIBUJ.

VERIF.

N.º DE DIBUJO | | A3

APROB.

PESO: | HOJA 1 DE 1

E | E
F | F

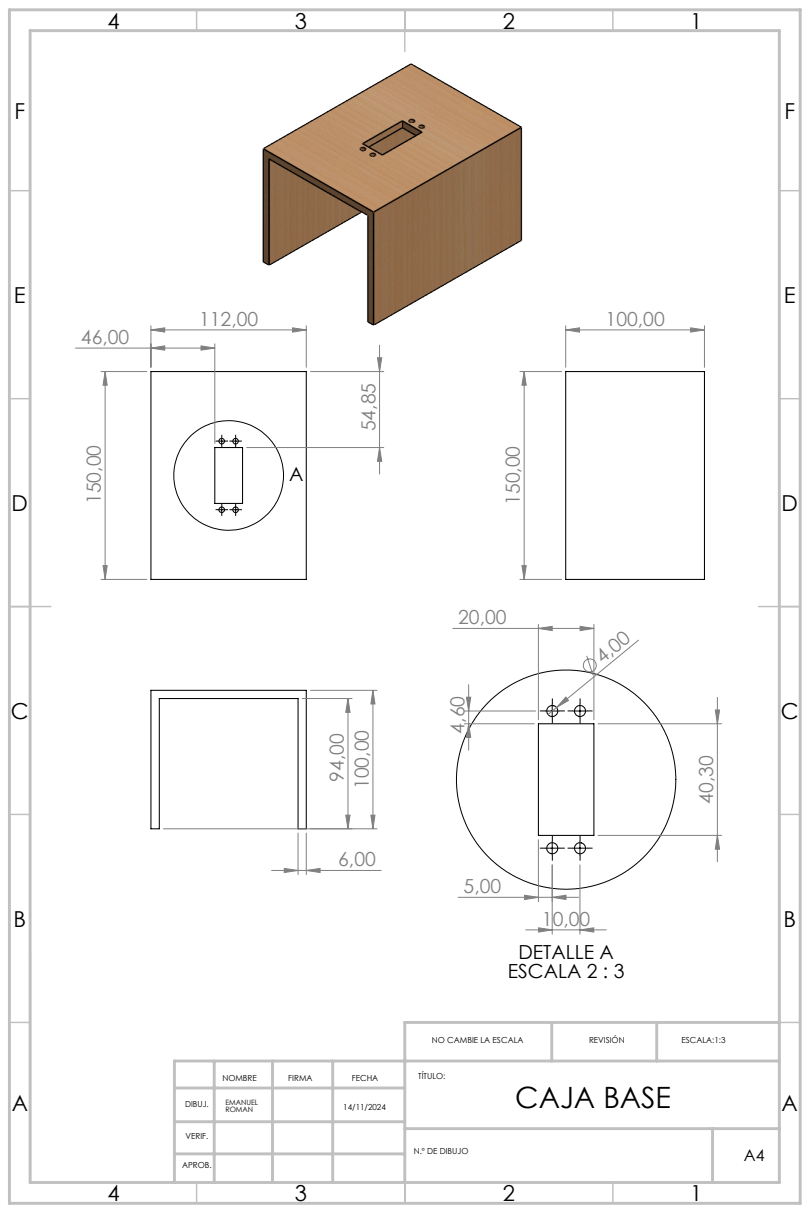
[picture p20: page 13]
10,00 DETALLE A ESCALA 2 : 3

NO CAMBIE LA ESCALA | REVISIÓN | ESCALA:1:3

NOMBRE | FIRMA | FECHA | TÍTULO: CAJA BASE

DIBUJ. | ROMAN | | 14/11/2024 EMANUEL

VERIF.

N.º DE DIBUJO | A4

APROB.

E | E
F | F

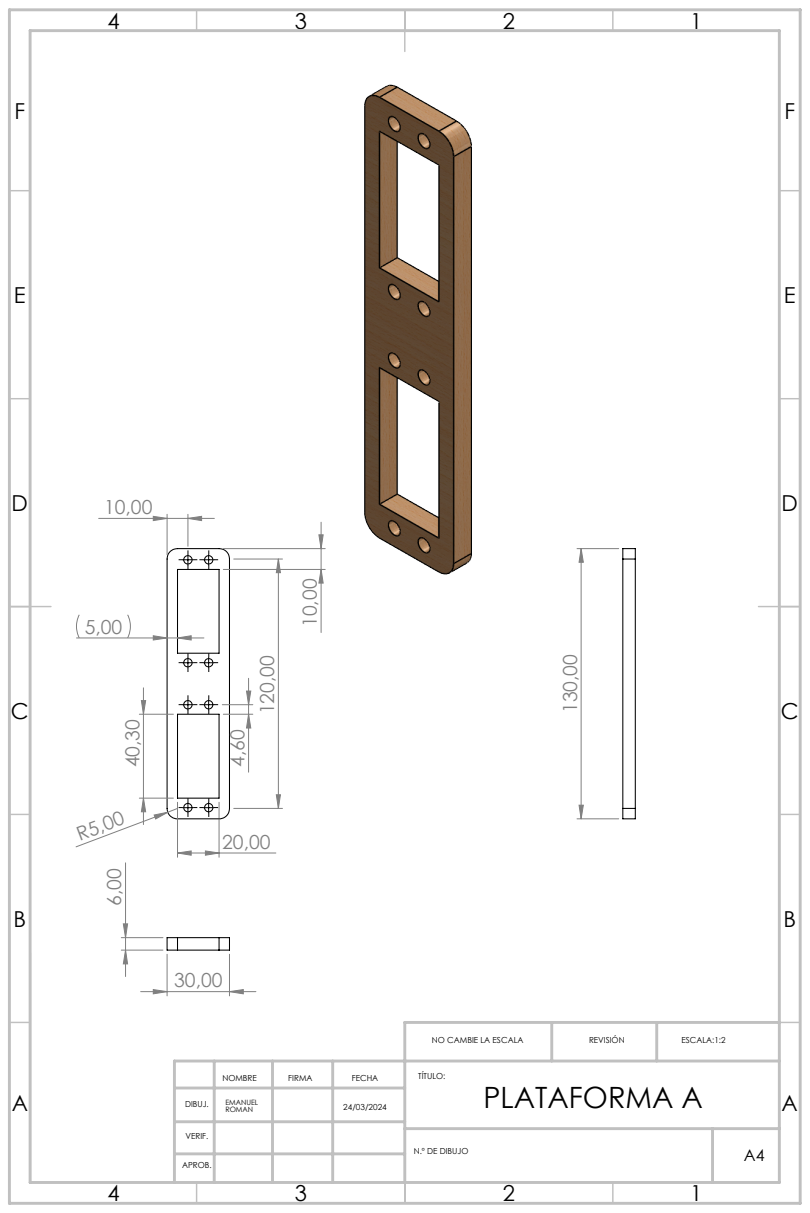
[picture p21: page 14]

NO CAMBIE LA ESCALA | REVISIÓN | ESCALA:1:2

NOMBRE | FIRMA | FECHA | TÍTULO: PLATAFORMA A

DIBUJ. | ROMAN | | 24/03/2024 EMANUEL

VERIF.

N.º DE DIBUJO | A4

APROB.

E | E
F | F

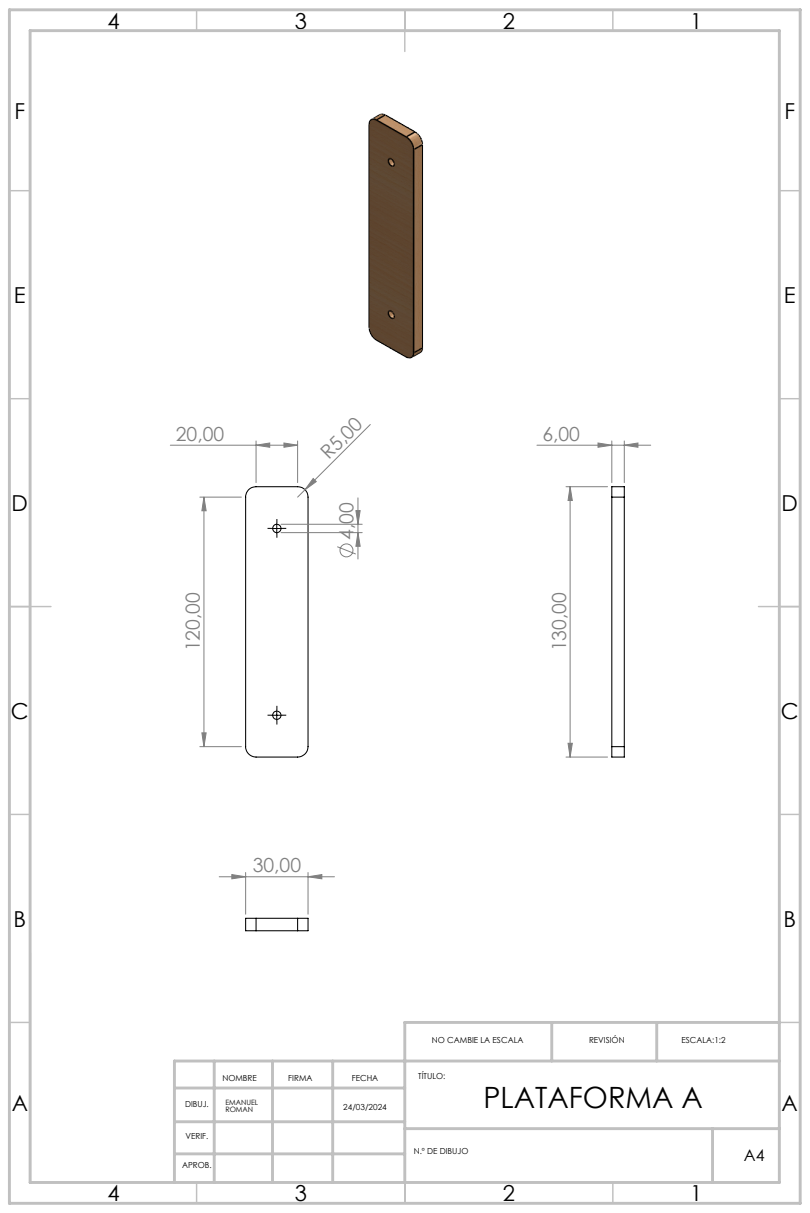
[picture p22: page 15]

NO CAMBIE LA ESCALA | REVISIÓN | ESCALA:1:2

NOMBRE | FIRMA | FECHA | TÍTULO: PLATAFORMA A

DIBUJ. | ROMAN | | 24/03/2024 EMANUEL

VERIF.

N.º DE DIBUJO | A4

APROB.

E | E
F | F

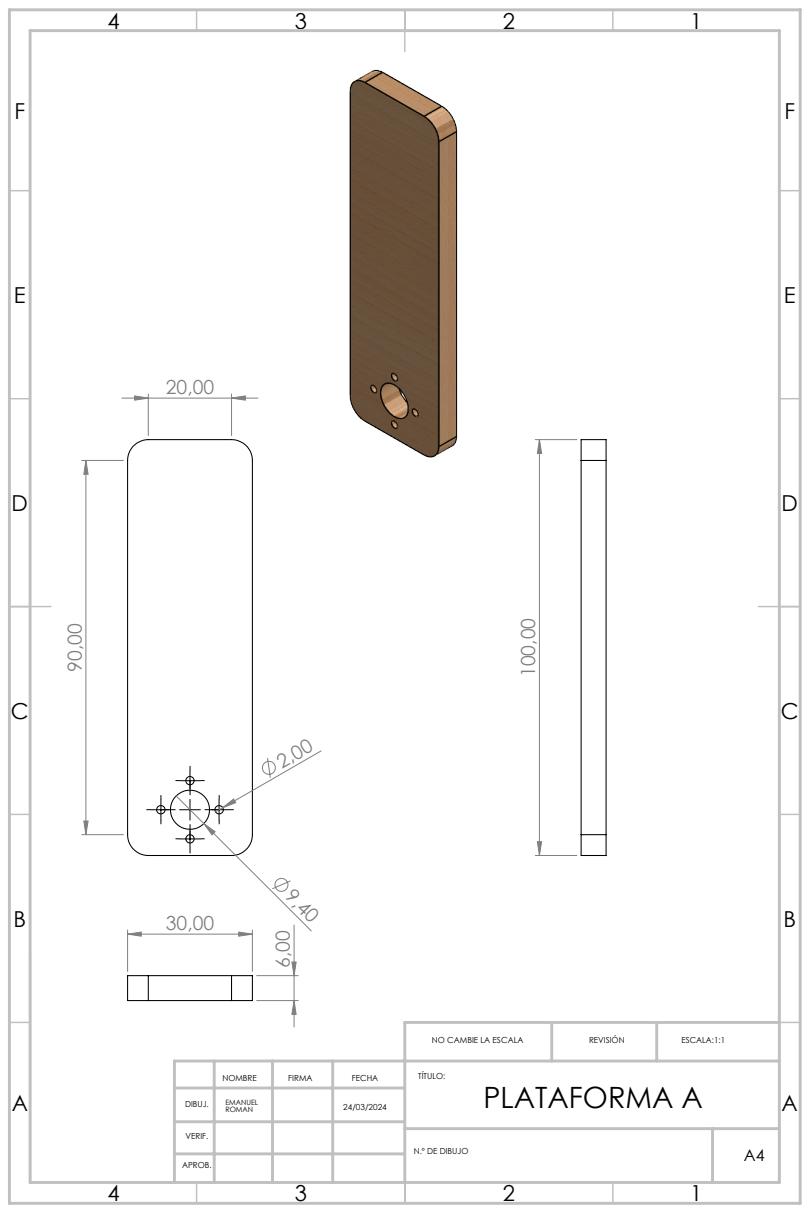
[picture p23: page 16]

NO CAMBIE LA ESCALA | REVISIÓN | ESCALA:1:1

NOMBRE | FIRMA | FECHA | TÍTULO: PLATAFORMA A

DIBUJ. | ROMAN | | 24/03/2024 EMANUEL

VERIF.

N.º DE DIBUJO | A4

APROB.

E | E
F | F

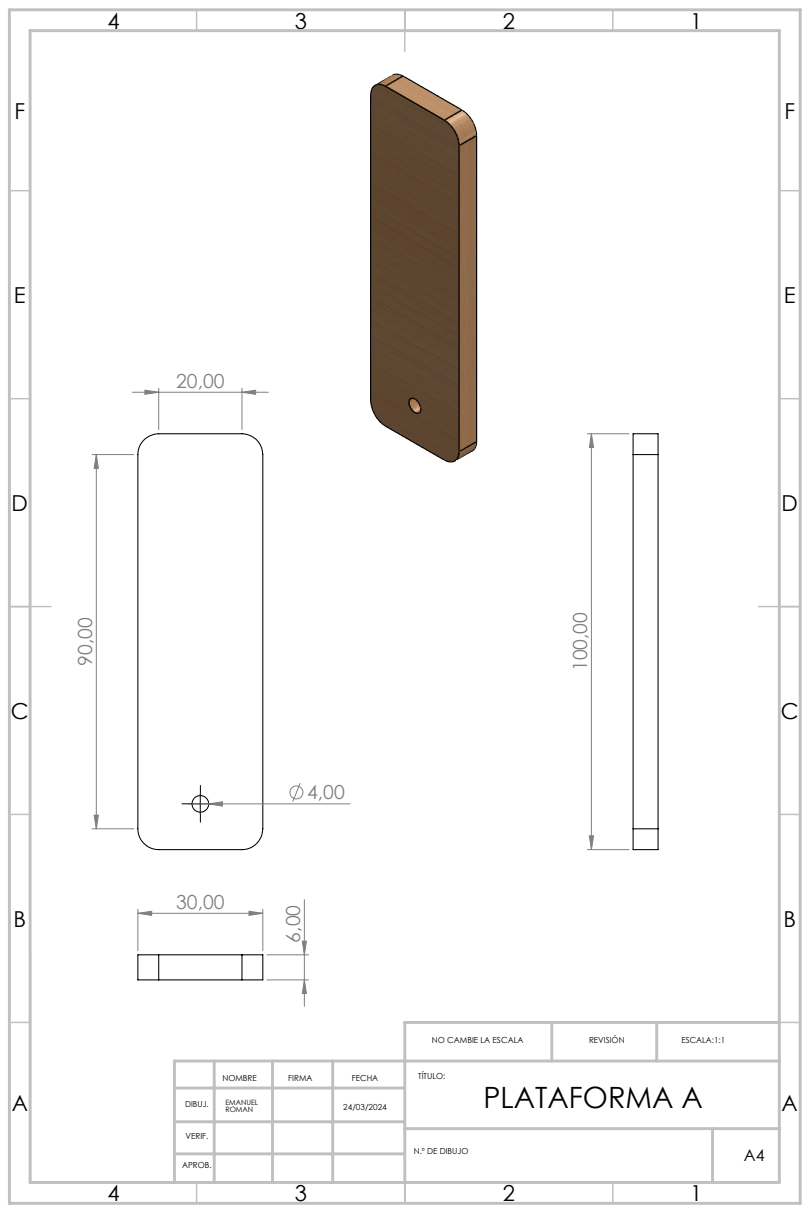
[picture p24: page 17]

NO CAMBIE LA ESCALA | REVISIÓN | ESCALA:1:1

NOMBRE | FIRMA | FECHA | TÍTULO: PLATAFORMA A

DIBUJ. | ROMAN | | 24/03/2024 EMANUEL

VERIF.

N.º DE DIBUJO | A4

APROB.

E | E
F | F

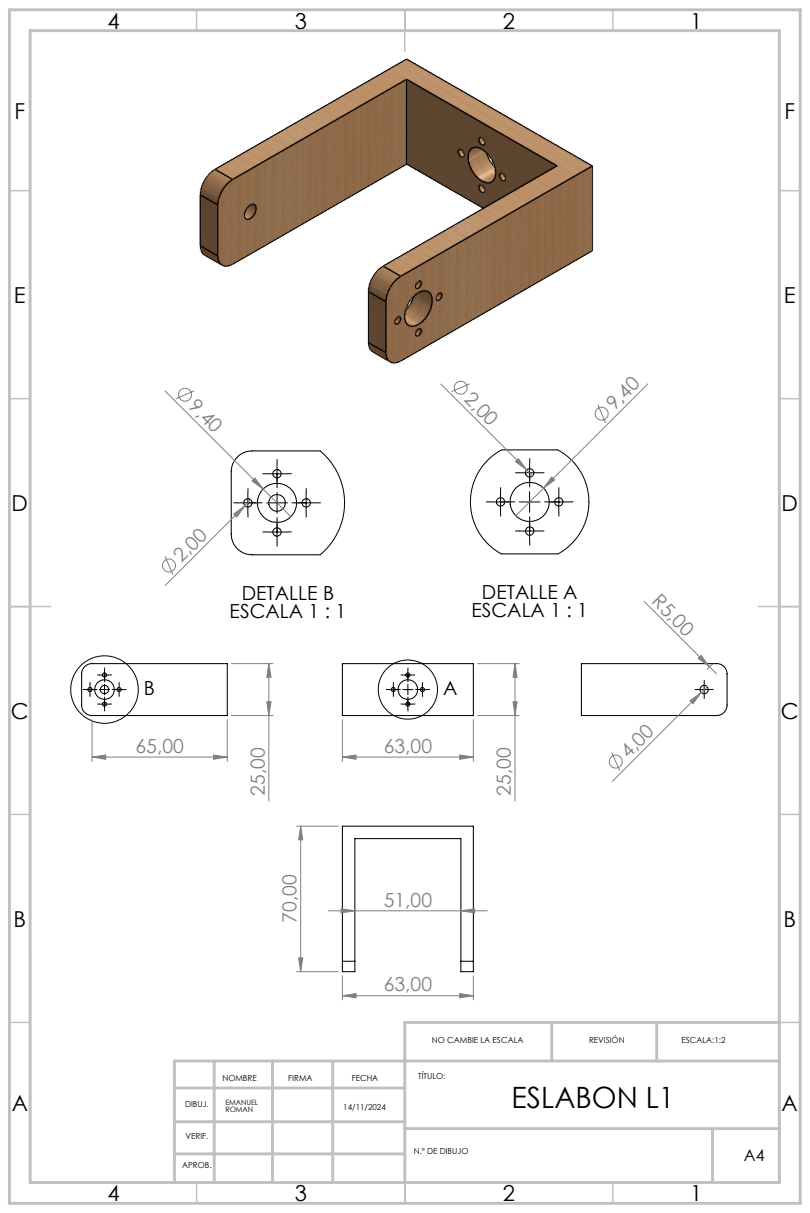
[picture p25: page 18]
DETALLE A ESCALA 1 : 1; DETALLE B ESCALA 1 : 1

NO CAMBIE LA ESCALA | REVISIÓN | ESCALA:1:2

NOMBRE | FIRMA | FECHA | TÍTULO: ESLABON L1

DIBUJ. | ROMAN | | 14/11/2024 EMANUEL

VERIF.

N.º DE DIBUJO | A4

APROB.
