ManuelRs1701/ROBOTICA/IMAGENES Y VIDEOS/FOTO REAL 2.jpg

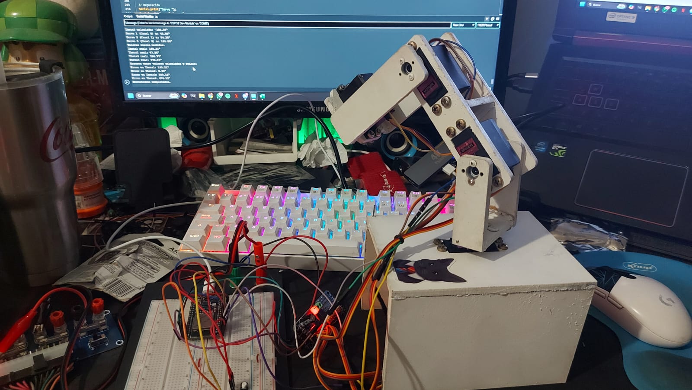
IMAGENES Y VIDEOS/FOTO REAL 2.jpg
